kira-iovenko/blare/cad/blare.step

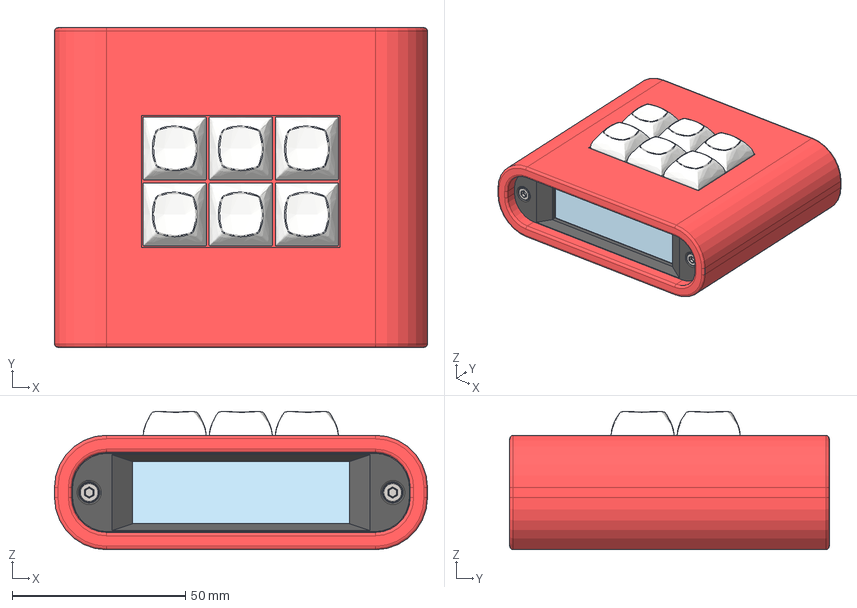
[picture p4: CAD file, 2026-10-31]
cad/blare.step
107.6 x 92.2 x 39.9 mm
