kira-iovenko/blare/pcb/blare.step

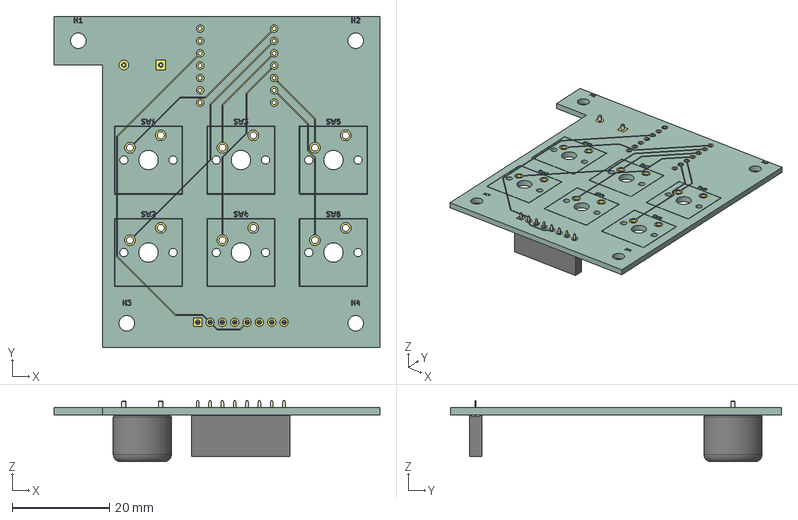
[picture p5: CAD file, 2026-10-31]
pcb/blare.step
67.2 x 68.2 x 12.6 mm
Buzzer_12x95RM76
PinSocket_1x08_P2.54mm_Vertical
blare_copper
blare_silkscreen x 2
blare_PCB
