kira-iovenko/blare/production/base.step

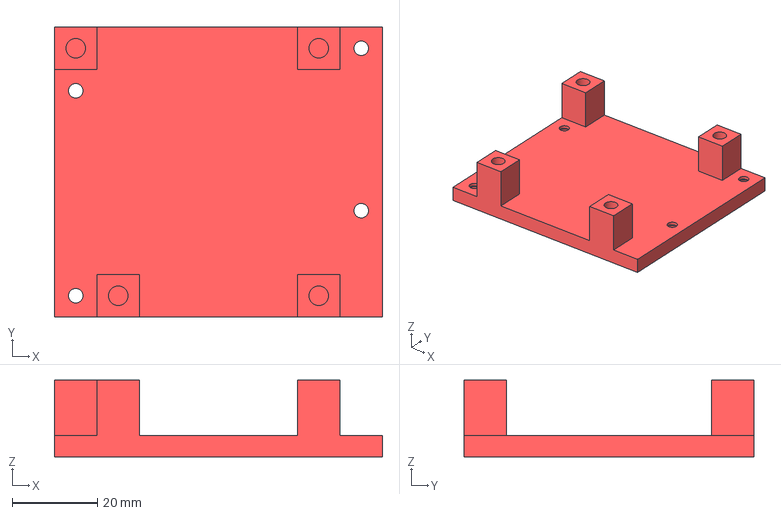
[picture p6: CAD file, 2026-10-31]
production/base.step
77.2 x 68.2 x 18.0 mm
