kira-iovenko/blare/production/case.step

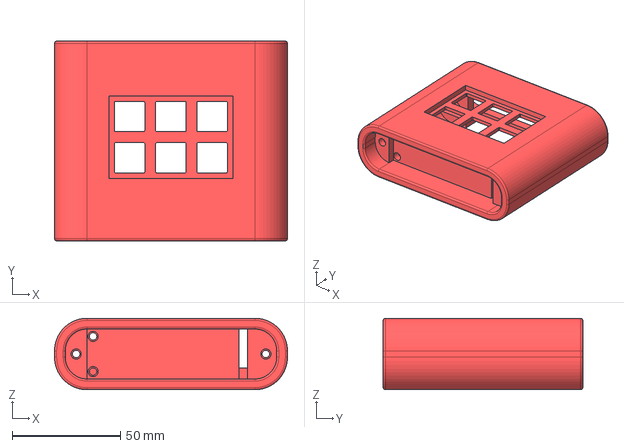
[picture p7: CAD file, 2026-10-31]
production/case.step
107.6 x 92.2 x 33.0 mm
