kira-iovenko/blare/production/front.step

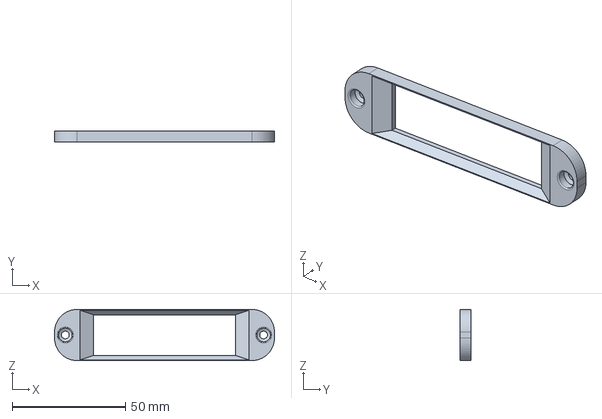
[picture p8: CAD file, 2026-10-31]
production/front.step
97.2 x 4.80 x 22.6 mm
