kira-iovenko/blare/production/back.step

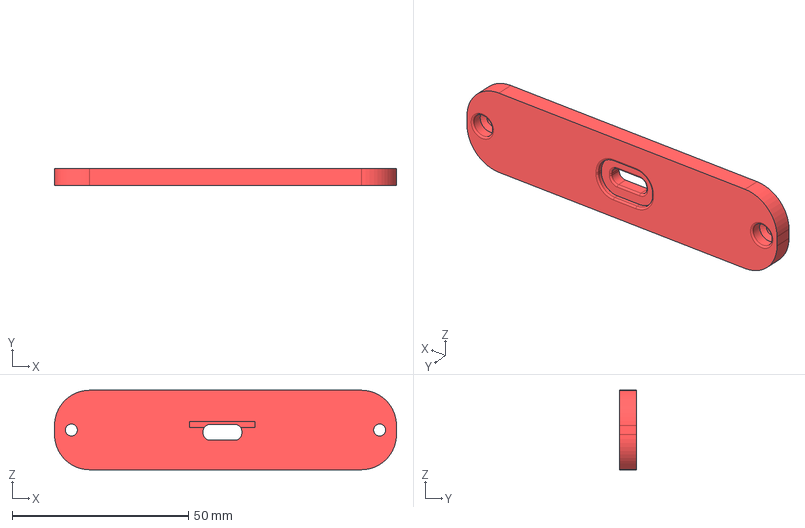
[picture p9: CAD file, 2026-10-31]
production/back.step
97.2 x 4.80 x 22.6 mm
