kira-iovenko/blare/pcb/blare.kicad_pcb

## KiCad design pcb/blare.kicad_pcb (2026-10-31)

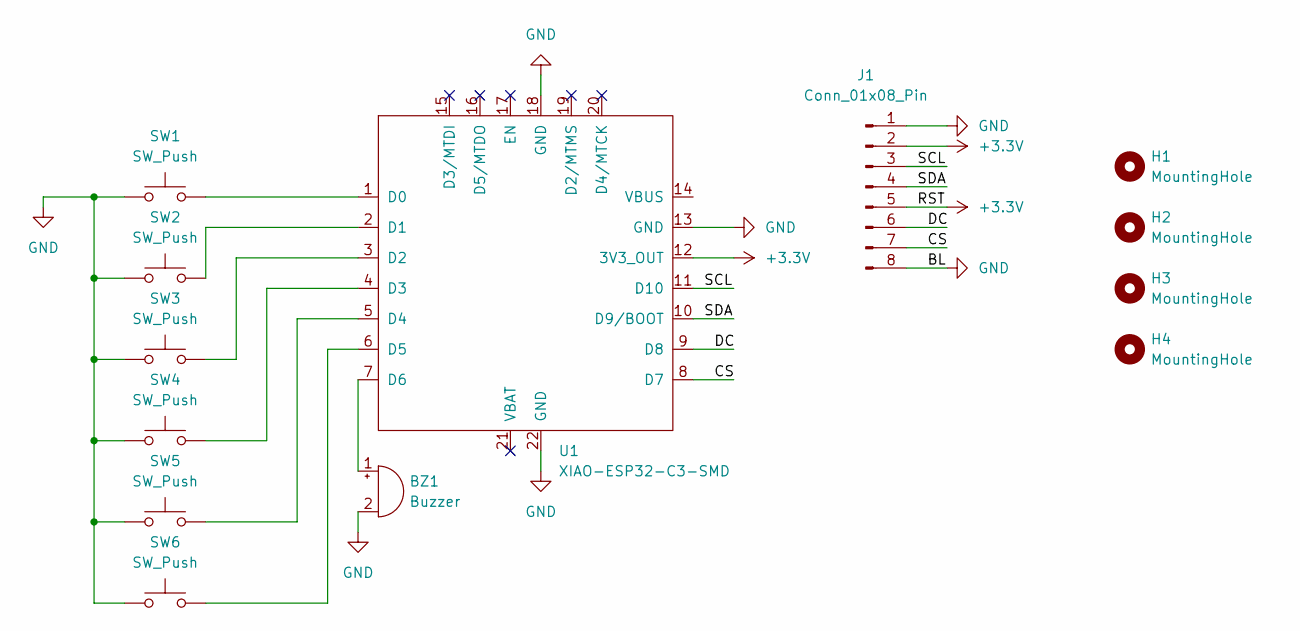
[picture p10: schematic blare.kicad_sch]

Parts:
BZ1: Buzzer; Buzzer_12x9.5RM7.6
H1, H2, H3, H4: MountingHole; MountingHole_3.2mm_M3
J1: Conn_01x08_Pin; PinSocket_1x08_P2.54mm_Vertical
SW1, SW2, SW3, SW4, SW5, SW6: SW_Push; SW_Cherry_MX_1.00u_PCB
U1: XIAO-ESP32-C3-SMD; XIAO-ESP32-C3-DIP-SMD

Connections:
+3.3V: J1.2, J1.5, U1.12 (3V3_OUT)
/CS: J1.7, U1.8 (D7)
/DC: J1.6, U1.9 (D8)
/SCL: J1.3, U1.11 (D10)
/SDA: J1.4, U1.10 (D9/BOOT)
GND: BZ1.2 (-), J1.1, J1.8, SW1.1, SW2.1, SW3.1, SW4.1, SW5.1, SW6.1, U1.13 (GND), U1.18 (GND), U1.22 (GND)
unnamed: BZ1.1 (+), U1.7 (D6)
unnamed: SW1.2, U1.1 (D0)
unnamed: SW2.2, U1.2 (D1)
unnamed: SW3.2, U1.3 (D2)
unnamed: SW4.2, U1.4 (D3)
unnamed: SW5.2, U1.5 (D4)
unnamed: SW6.2, U1.6 (D5)

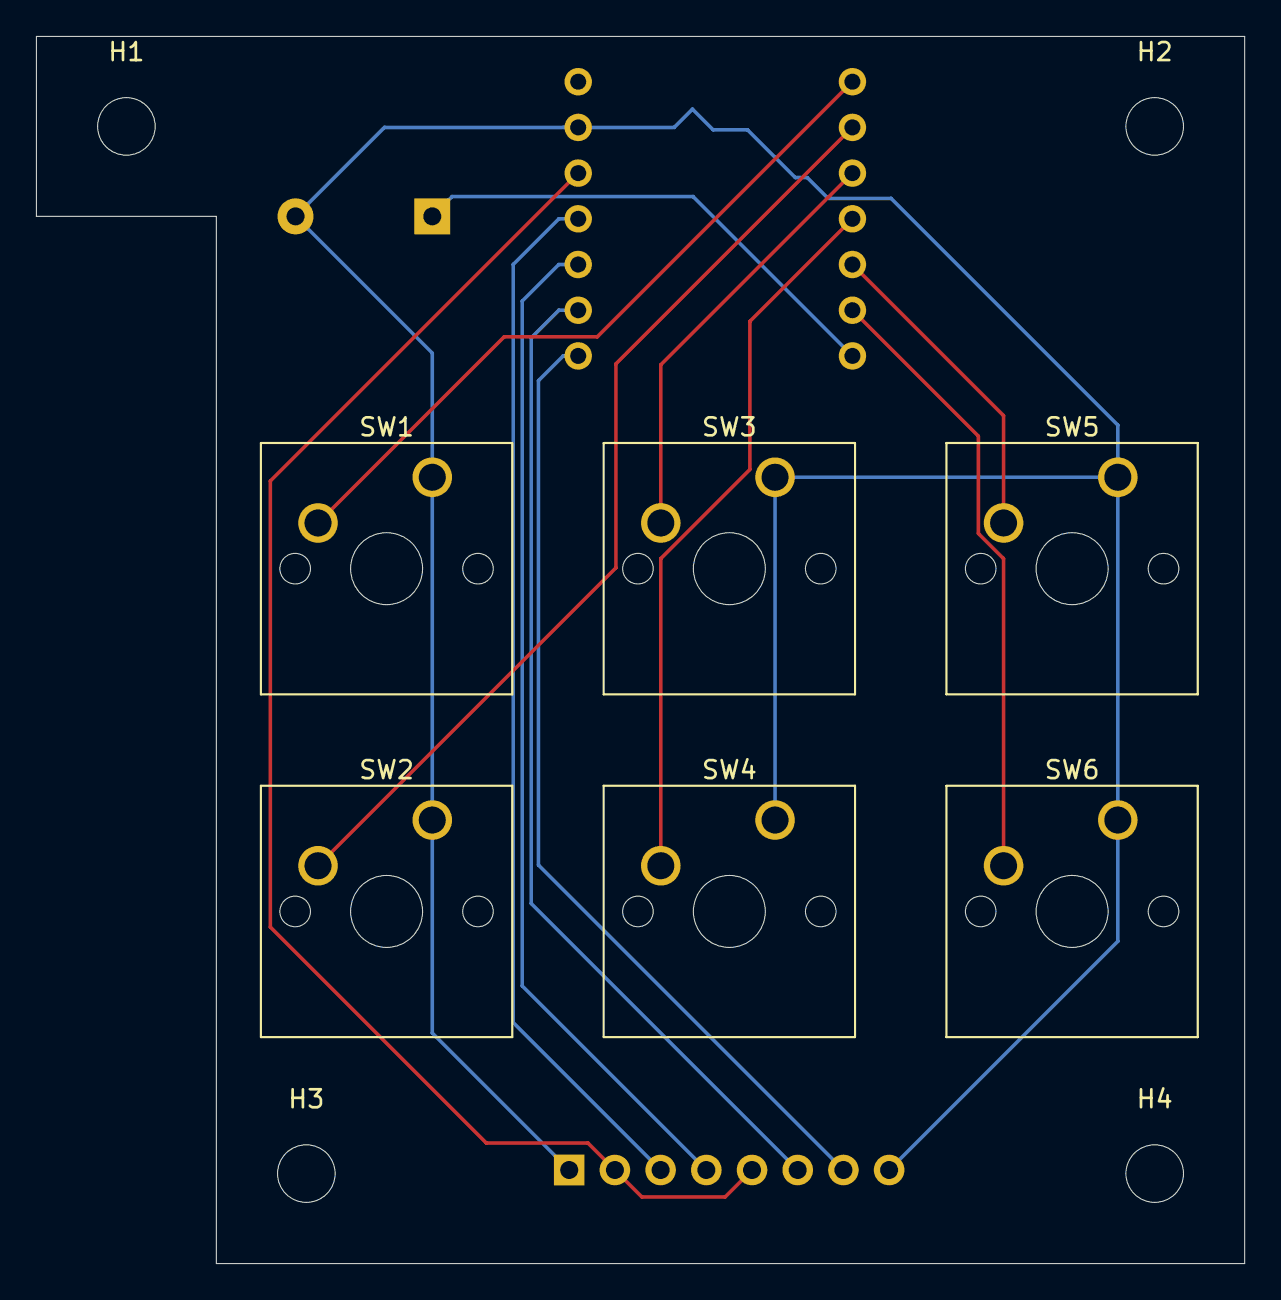
[picture p11: board blare.kicad_pcb from above]

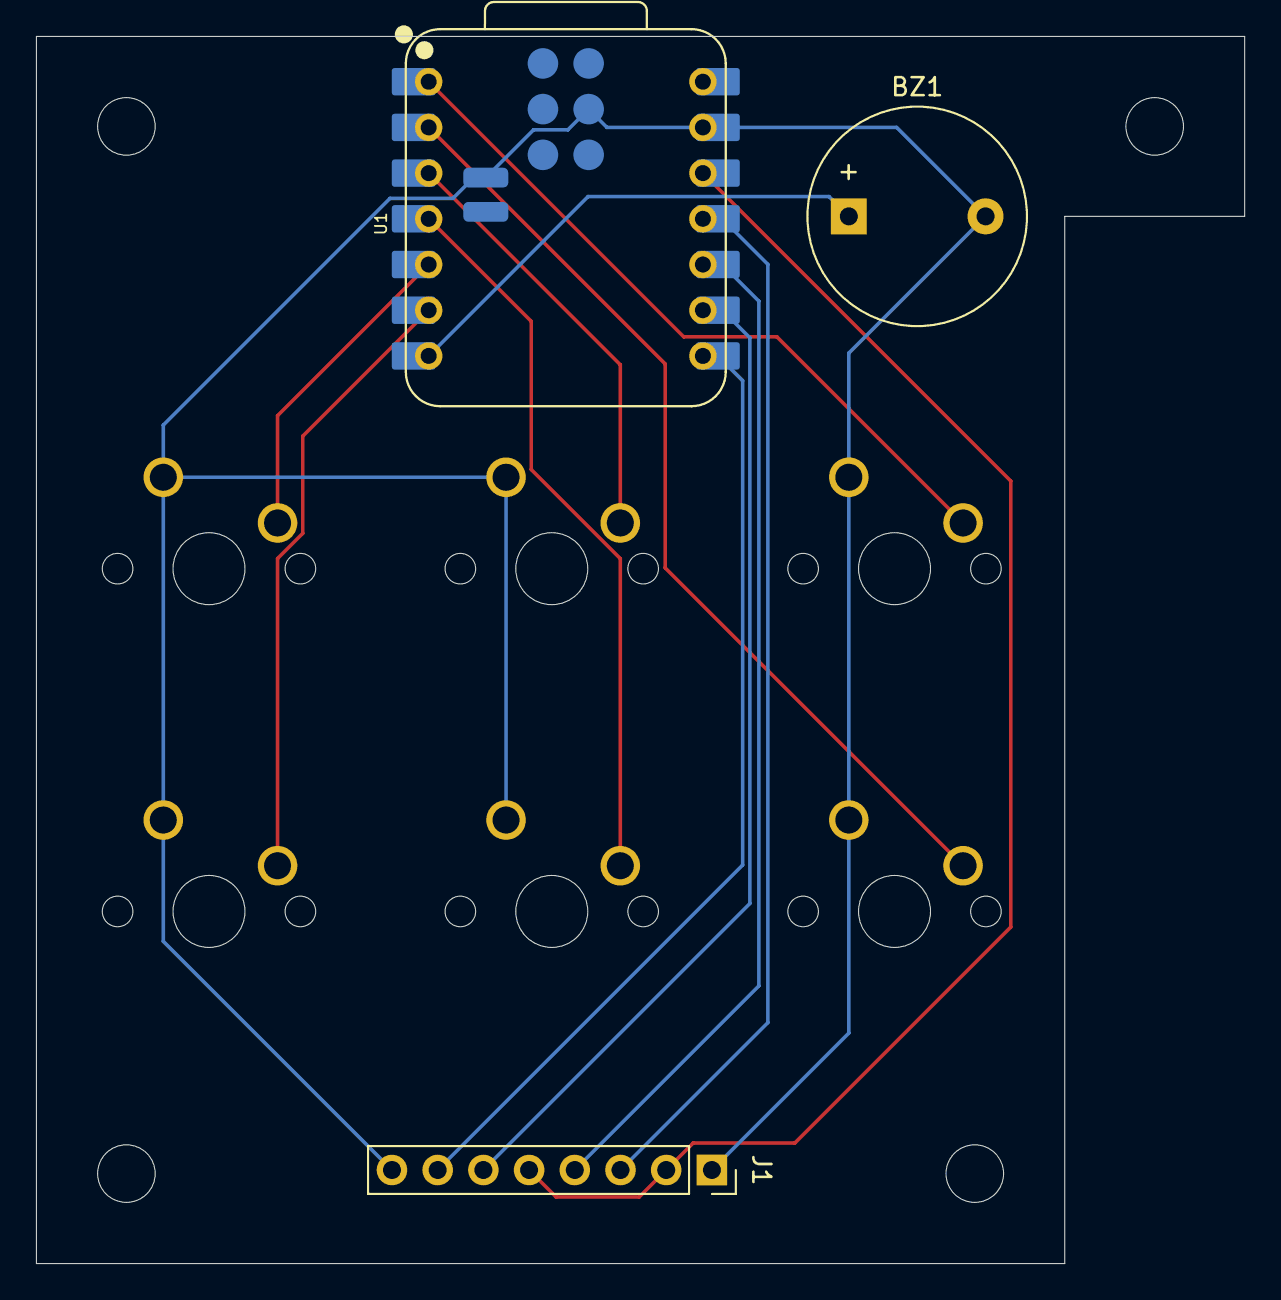
[picture p12: board blare.kicad_pcb from below]

Board: 2 copper layers, 67.2 x 68.2 mm, 13 parts (3 on the bottom side), 13 nets.
