kira-iovenko/blare/firmware/secrets.example.h

// Copy this file to secrets.h (same folder) and fill in your WiFi.
// secrets.h is git-ignored so your password never ends up on GitHub.
// Leave the SSID empty to run without WiFi (set the clock from the menu).
#pragma once

#define WIFI_SSID     "your-wifi-name"
#define WIFI_PASSWORD "your-wifi-password"
