kira-iovenko/blare/(commit log)

2026-10-31 Add case design
2026-10-31 Export gerber files
2026-10-31 Export case parts
2026-10-31 Update firmware to support my PCB
2026-11-01 Add BOM
